karliss/E4000/hardware/ne_4000/natural_ergo_4000.kicad_pcb

## KiCad design hardware/ne_4000/natural_ergo_4000.kicad_pcb (2017-09-06)

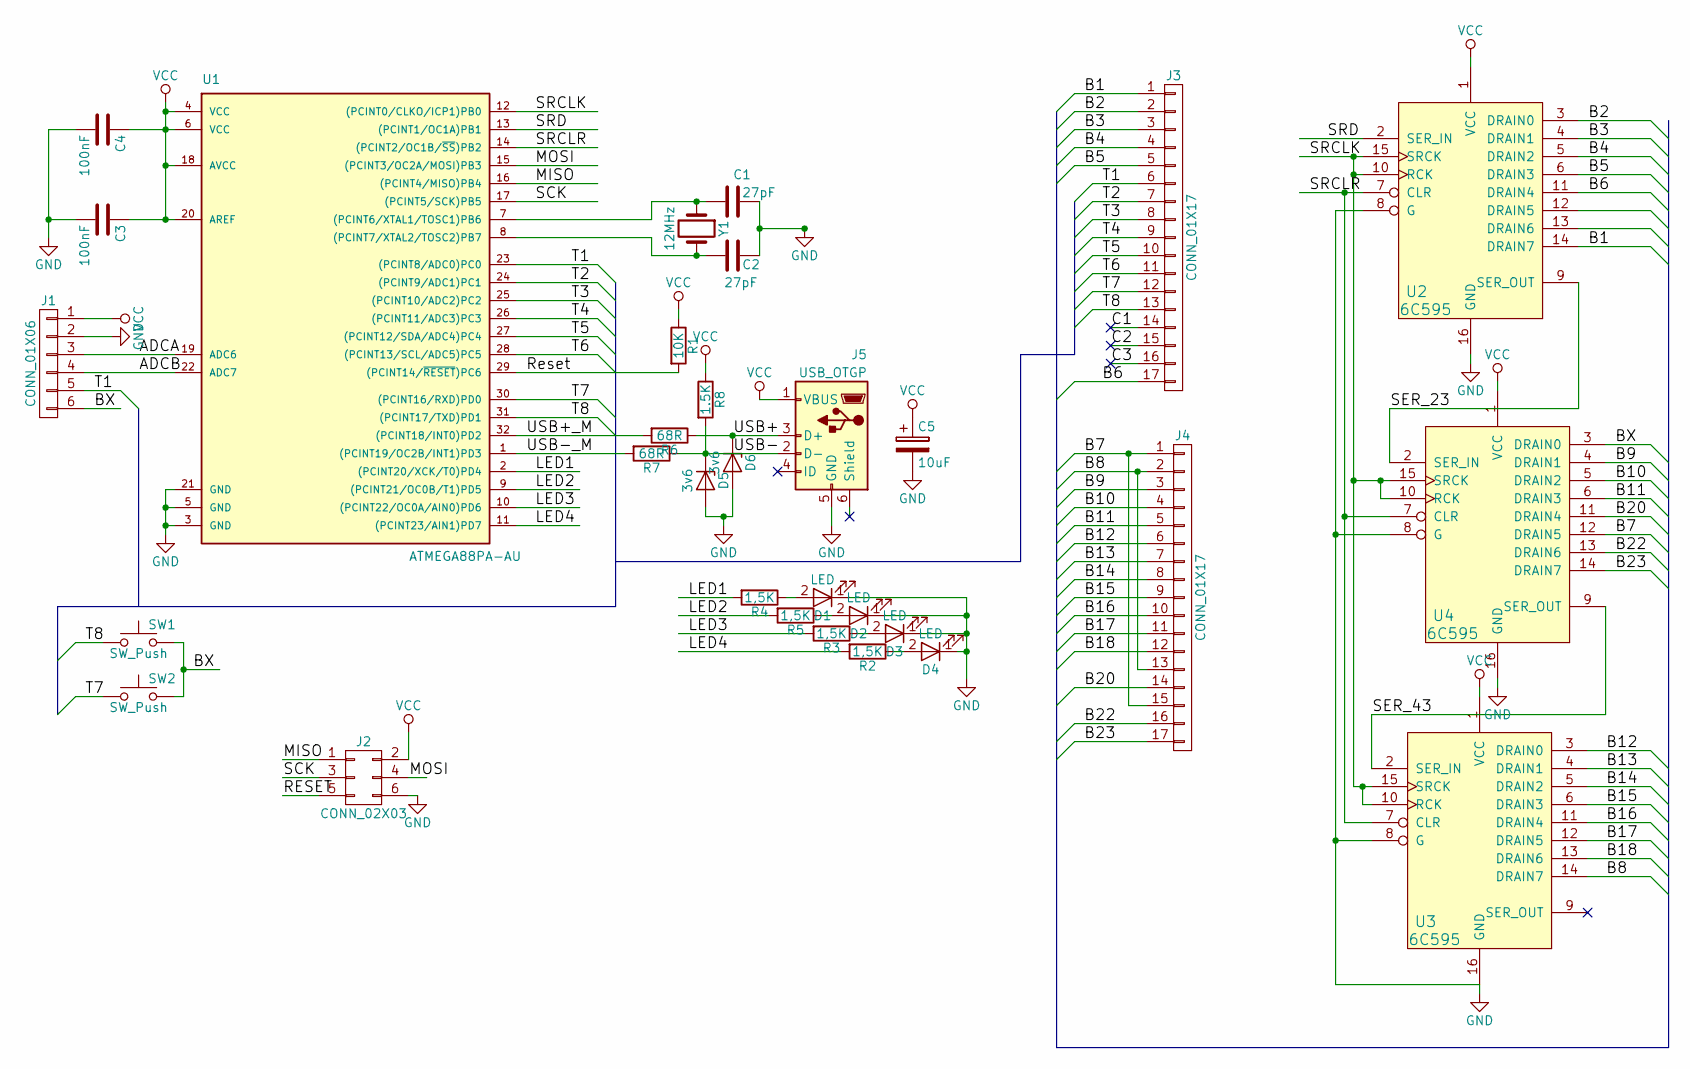
[picture p1: schematic natural_ergo_4000.sch, Natural Ergonomic 4000 replacement board]

Parts:
C1, C2: 27pF; C_Disc_D5.0mm_W2.5mm_P5.00mm
C3, C4: 100nF; C_0805
C5: 10uF; CP_Radial_D5.0mm_P2.50mm
D1, D2, D3, D4: LED; LED_D3.0mm
D5, D6: 3v6; D_DO-35_SOD27_P7.62mm_Horizontal
J1: CONN_01X06; Pin_Header_Straight_1x06_Pitch2.54mm
J2: CONN_02X03; Pin_Header_Straight_2x03_Pitch2.54mm
J3, J4: CONN_01X17; test_pad
J5: USB_OTGP; USB_Mini-B
R1: 10K; R_0805_HandSoldering
R2, R3, R4, R5: 1,5K; R_0805_HandSoldering
R6, R7: 68R; R_0805_HandSoldering
R8: 1.5K; R_0805_HandSoldering
SW1, SW2: SW_Push; SW_PUSH_6mm
U1: ATMEGA88PA-AU; LQFP-32_7x7mm_Pitch0.8mm
U2, U3, U4: 6C595; SOIC-16_3.9x9.9mm_Pitch1.27mm
Y1: 12MHz; Crystal_HC49-4H_Vertical

Connections:
/ADCA: J1.3, U1.19 (ADC6)
/ADCB: J1.4, U1.22 (ADC7)
/B1: J3.1, U2.14 (DRAIN7)
/B2: J3.2, U2.3 (DRAIN0)
/B3: J3.3, U2.4 (DRAIN1)
/B4: J3.4, U2.5 (DRAIN2)
/B5: J3.5, U2.6 (DRAIN3)
/B6: J3.17, U2.11 (DRAIN4)
/B7: J4.1, J4.15, U4.12 (DRAIN5)
/B8: J4.2, J4.13, U3.14 (DRAIN7)
/B9: J4.3, U4.4 (DRAIN1)
/B10: J4.4, U4.5 (DRAIN2)
/B11: J4.5, U4.6 (DRAIN3)
/B12: J4.6, U3.3 (DRAIN0)
/B13: J4.7, U3.4 (DRAIN1)
/B14: J4.8, U3.5 (DRAIN2)
/B15: J4.9, U3.6 (DRAIN3)
/B16: J4.10, U3.11 (DRAIN4)
/B17: J4.11, U3.12 (DRAIN5)
/B18: J4.12, U3.13 (DRAIN6)
/B20: J4.14, U4.11 (DRAIN4)
/B22: J4.16, U4.13 (DRAIN6)
/B23: J4.17, U4.14 (DRAIN7)
/BX: J1.6, SW1.2, SW2.2, U4.3 (DRAIN0)
/C1: J3.14
/C2: J3.15
/C3: J3.16
/LED1: R4.2, U1.2 ((PCINT20/XCK/T0)PD4)
/LED2: R5.2, U1.9 ((PCINT21/OC0B/T1)PD5)
/LED3: R3.2, U1.10 ((PCINT22/OC0A/AIN0)PD6)
/LED4: R2.2, U1.11 ((PCINT23/AIN1)PD7)
/MISO: J2.1, U1.16 ((PCINT4/MISO)PB4)
/MOSI: J2.4, U1.15 ((PCINT3/OC2A/MOSI)PB3)
/RESET: J2.5, R1.2, U1.29 ((PCINT14/~RESET~)PC6)
/SCK: J2.3, U1.17 ((PCINT5/SCK)PB5)
/SER_23: U2.9 (SER_OUT), U4.2 (SER_IN)
/SER_43: U3.2 (SER_IN), U4.9 (SER_OUT)
/SRCLK: U1.12 ((PCINT0/CLKO/ICP1)PB0), U2.10 (RCK), U2.15 (SRCK), U3.10 (RCK), U3.15 (SRCK), U4.10 (RCK), U4.15 (SRCK)
/SRCLR: U1.14 ((PCINT2/OC1B/~SS~)PB2), U2.7 (CLR), U3.7 (CLR), U4.7 (CLR)
/SRD: U1.13 ((PCINT1/OC1A)PB1), U2.2 (SER_IN)
/T1: J1.5, J3.6, U1.23 ((PCINT8/ADC0)PC0)
/T2: J3.7, U1.24 ((PCINT9/ADC1)PC1)
/T3: J3.8, U1.25 ((PCINT10/ADC2)PC2)
/T4: J3.9, U1.26 ((PCINT11/ADC3)PC3)
/T5: J3.10, U1.27 ((PCINT12/SDA/ADC4)PC4)
/T6: J3.11, U1.28 ((PCINT13/SCL/ADC5)PC5)
/T7: J3.12, SW2.1, U1.30 ((PCINT16/RXD)PD0)
/T8: J3.13, SW1.1, U1.31 ((PCINT17/TXD)PD1)
/USB+: D6.1 (K), J5.3 (D+), R6.1
/USB+_M: R6.2, U1.32 ((PCINT18/INT0)PD2)
/USB-: D5.1 (K), J5.2 (D-), R7.1, R8.2
/USB-_M: R7.2, U1.1 ((PCINT19/OC2B/INT1)PD3)
GND: C1.1, C2.1, C3.2, C4.2, C5.2, D1.1 (K), D2.1 (K), D3.1 (K), D4.1 (K), D5.2 (A), D6.2 (A), J1.2, J2.6, J5.5 (GND), U1.3 (GND), U1.5 (GND), U1.21 (GND), U2.8 (G), U2.16 (GND), U3.8 (G), U3.16 (GND), U4.8 (G), U4.16 (GND)
unnamed: C1.2, U1.7 ((PCINT6/XTAL1/TOSC1)PB6), Y1.1
unnamed: C2.2, U1.8 ((PCINT7/XTAL2/TOSC2)PB7), Y1.2
unnamed: D1.2 (A), R4.1
unnamed: D2.2 (A), R5.1
unnamed: D3.2 (A), R3.1
unnamed: D4.2 (A), R2.1
VCC: C3.1, C4.1, C5.1, J1.1, J2.2, J5.1 (VBUS), R1.1, R8.1, U1.4 (VCC), U1.6 (VCC), U1.18 (AVCC), U1.20 (AREF), U2.1 (VCC), U3.1 (VCC), U4.1 (VCC)

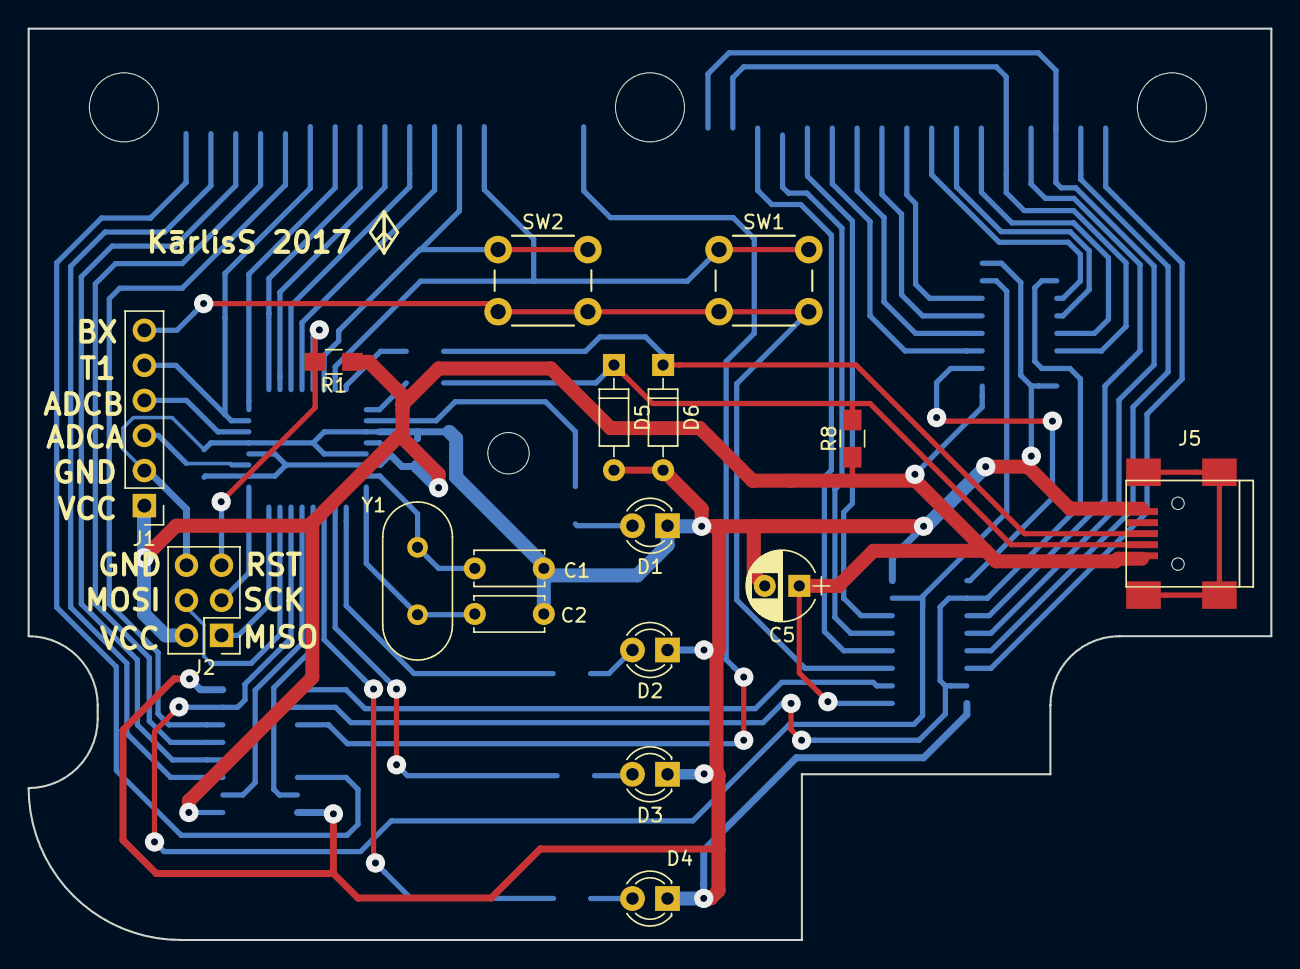
[picture p2: board natural_ergo_4000.kicad_pcb from above]

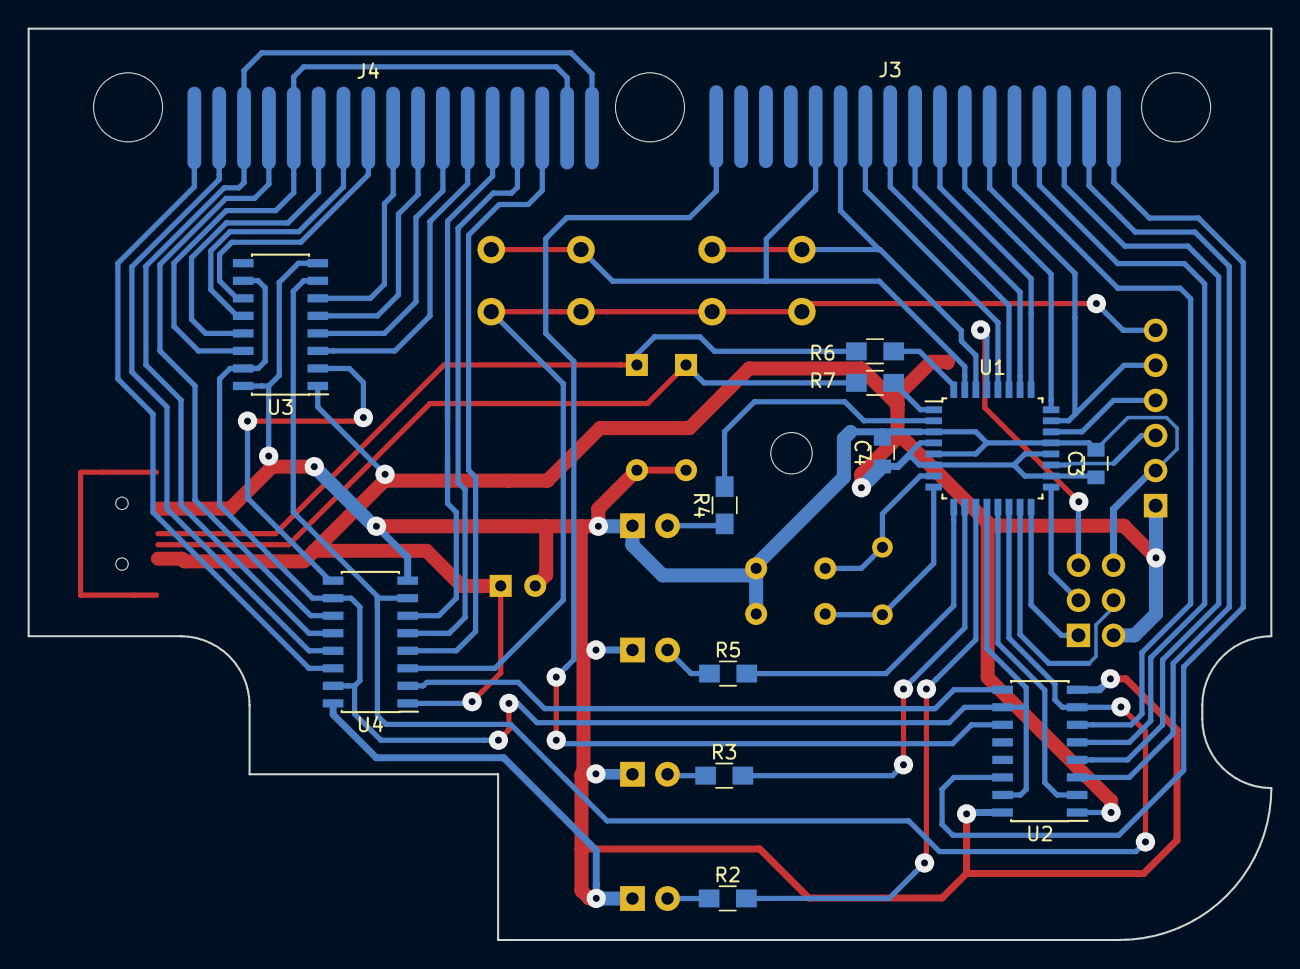
[picture p3: board natural_ergo_4000.kicad_pcb from below]

Board: 2 copper layers, 90.0 x 66.0 mm, 31 parts (14 on the bottom side), 57 nets.
