karliss/E4000/(threads)

Thread 1 (2017-06-04):

Reduce current flow between columns.

karliss, 2017-06-04:
Shift registers used for driving columns operate in push pull mode. This will cause unwanted current between columns when two keys from the same row are pressed.

Possible solutions:
* add diodes
* find a shift register with open drain outputs
* increase resistance

Closed 2017-07-30.
