karliss/E4000/src/usbconfig.h

#pragma once

#define USB_CFG_IOPORTNAME      D
#define USB_CFG_DMINUS_BIT      3
#define USB_CFG_DPLUS_BIT       2
#define USB_CFG_CLOCK_KHZ       (F_CPU/1000)
#define USB_CFG_CHECK_CRC       0

/* #define USB_CFG_PULLUP_IOPORTNAME   D */
/* #define USB_CFG_PULLUP_BIT          4 */


#define USB_CFG_HAVE_INTRIN_ENDPOINT    1
/* Define this to 1 if you want to compile a version with two endpoints: The
 * default control endpoint 0 and an interrupt-in endpoint (any other endpoint
 * number).
 */
#define USB_CFG_HAVE_INTRIN_ENDPOINT3   0
#define USB_CFG_EP3_NUMBER              3

/* #define USB_INITIAL_DATATOKEN           USBPID_DATA1 */

#define USB_CFG_IMPLEMENT_HALT          0

#define USB_CFG_SUPPRESS_INTR_CODE      0

#define USB_CFG_INTR_POLL_INTERVAL      20
#define USB_CFG_IS_SELF_POWERED         0

#define USB_CFG_MAX_BUS_POWER           50

#define USB_CFG_IMPLEMENT_FN_WRITE      1
#define USB_CFG_IMPLEMENT_FN_READ       0
/* Set this to 1 if you need to send control replies which are generated
 * "on the fly" when usbFunctionRead() is called. If you only want to send
 * data from a static buffer, set it to 0 and return the data from
 * usbFunctionSetup(). This saves a couple of bytes.
 */
#define USB_CFG_IMPLEMENT_FN_WRITEOUT   0
/* Define this to 1 if you want to use interrupt-out (or bulk out) endpoints.
 * You must implement the function usbFunctionWriteOut() which receives all
 * interrupt/bulk data sent to any endpoint other than 0. The endpoint number
 * can be found in 'usbRxToken'.
 */
#define USB_CFG_HAVE_FLOWCONTROL        0
/* Define this to 1 if you want flowcontrol over USB data. See the definition
 * of the macros usbDisableAllRequests() and usbEnableAllRequests() in
 * usbdrv.h.
 */
#define USB_CFG_DRIVER_FLASH_PAGE       0
/* If the device has more than 64 kBytes of flash, define this to the 64 k page
 * where the driver's constants (descriptors) are located. Or in other words:
 * Define this to 1 for boot loaders on the ATMega128.
 */
#define USB_CFG_LONG_TRANSFERS          0
/* Define this to 1 if you want to send/receive blocks of more than 254 bytes
 * in a single control-in or control-out transfer. Note that the capability
 * for long transfers increases the driver size.
 */
/* #define USB_RX_USER_HOOK(data, len)     if(usbRxToken == (uchar)USBPID_SETUP) blinkLED(); */

/* #define USB_RESET_HOOK(resetStarts)     if(!resetStarts){hadUsbReset();} */
/* This macro is a hook if you need to know when an USB RESET occurs. It has
 * one parameter which distinguishes between the start of RESET state and its
 * end.
 */
/* #define USB_SET_ADDRESS_HOOK()              hadAddressAssigned(); */
/* This macro (if defined) is executed when a USB SET_ADDRESS request was
 * received.
 */
#define USB_COUNT_SOF                   0
#define USB_CFG_CHECK_DATA_TOGGLING     0
#define USB_CFG_HAVE_MEASURE_FRAME_LENGTH   0
#define USB_USE_FAST_CRC                0

#define  USB_CFG_VENDOR_ID       0xc0, 0x16 /*  voti.nl */
#define  USB_CFG_DEVICE_ID       0xdb, 0x27

#define USB_CFG_DEVICE_VERSION  0x00, 0x01

#define USB_CFG_VENDOR_NAME     'h', 't', 't', 'p', 's', ':', '/', '/', 'g', 'i', 't', 'h', 'u', 'b', '.', 'c', 'o', 'm', '/', 'k', 'a', 'r', 'l', 'i', 's', 's', '/', 'E', '4', '0', '0', '0'
#define USB_CFG_VENDOR_NAME_LEN 32
#define USB_CFG_DEVICE_NAME     'E', '4', '0', '0', '0'
#define USB_CFG_DEVICE_NAME_LEN 5

/*#define USB_CFG_SERIAL_NUMBER   'N', 'o', 'n', 'e' */
/*#define USB_CFG_SERIAL_NUMBER_LEN   0 */


#define USB_CFG_DEVICE_CLASS        0
#define USB_CFG_DEVICE_SUBCLASS     0

#define USB_CFG_INTERFACE_CLASS     3
#define USB_CFG_INTERFACE_SUBCLASS  1
#define USB_CFG_INTERFACE_PROTOCOL  1

#define USB_CFG_HID_REPORT_DESCRIPTOR_LENGTH    63

/* #define USB_PUBLIC static */

#define USB_CFG_DESCR_PROPS_DEVICE                  0
#define USB_CFG_DESCR_PROPS_CONFIGURATION           0
#define USB_CFG_DESCR_PROPS_STRINGS                 0
#define USB_CFG_DESCR_PROPS_STRING_0                0
#define USB_CFG_DESCR_PROPS_STRING_VENDOR           0
#define USB_CFG_DESCR_PROPS_STRING_PRODUCT          0
#define USB_CFG_DESCR_PROPS_STRING_SERIAL_NUMBER    0
#define USB_CFG_DESCR_PROPS_HID                     0
#define USB_CFG_DESCR_PROPS_HID_REPORT              0
#define USB_CFG_DESCR_PROPS_UNKNOWN                 0


/* #define usbMsgPtr_t unsigned short */ /* uchar* by default */
