karliss/E4000/src/matrix_mapping.h

static const uint8_t MATRIX_MAPPING[24][8] PROGMEM = 
{
{0,0,25,227,0,60,30,0},
{0,0,0,0,0,20,0,0},
{0,0,41,0,0,63,33,224},
{226,0,0,0,0,61,31,127},
{0,0,0,0,0,8,0,0},
{0,0,0,0,0,0,0,0},
{0,0,0,0,0,0,0,0},
{0,0,0,0,0,26,0,0},
{0,0,0,0,0,0,0,0},
{19,5,64,28,36,4,53,10},
{47,17,65,24,37,22,45,11},
{48,16,66,12,38,7,46,52},
{182,0,197,0,183,72,73,103},
{97,99,0,85,94,21,51,91},
{95,79,118,83,92,0,14,89},
{96,98,0,84,93,0,15,90},
{230,0,29,0,0,44,55,128},
{0,0,6,0,0,59,100,228},
{0,54,67,18,39,9,34,49},
{0,0,40,0,225,62,32,0},
{0,0,27,0,229,58,56,129},
{74,80,68,70,76,43,35,82},
{77,81,69,71,75,0,13,78},
{87,57,0,86,0,23,42,88},
};
