karliss/E4000/(commit log)

2017-06-04 Added pcb schematics.
    [natural_ergo_4000.kicad_pcb, natural_ergo_4000.sch]
2017-07-30 Replace shift registers with open drain version.
    [natural_ergo_4000.kicad_pcb, natural_ergo_4000.sch]
2017-09-06 Adjust PCB layout spacing
    * increase spacing around middle screw
    * move R8 to allow vertical cappacitor mounting
    * add more labels
    [natural_ergo_4000.kicad_pcb]
2020-02-27 Last commit in AVR branch with unknown set of changes.
    [key_list1.ods, r1.csv, table1.csv]
2020-02-27 Third attempt at saving kicad files.
    [natural_ergo_4000.sch]
